UWRobotRacing/RR-Hummingbot-Hardware/Notes/Calibrations.xlsx

THROTTLE |  |  |  | STEERING
Input | Ideal | Measured | Delta | Input | Ideal | Measured | Delta | max | min |  | ROC
cm/s | us | us | us | degree | us | us | us | 200 | 10 | cm/s | 1.157894737
100 | 1684 | 1702 | 18 | 0 | 1500 | 1503 | 3 | 1800 | 1580
150 | 1742 | 1802 | 60 | 15 | 1616 | 1653 | 37
190 | 1788 | 1802 | 14 | 45 | 1850 | 1853 | 3 | -90 | 90 | deg | 7.777777778
 |  |  | 0 |  |  |  | 0 | 800 | 2200
 |  |  | 0 |  |  |  | 0
 |  |  | 0 |  |  |  | 0
 |  |  | 0 |  |  |  | 0
 |  |  |  |  |  |  | 0 | Resolution: | 50us | 5 deg
 |  |  |  |  |  |  | 0
