UWRobotRacing/RR-Hummingbot-Hardware/Electrical/PCB/hummingboard/v1/RR2019_Main_Board_V1/SENSOR_ACTUATOR.pdf

## 3 J11

## 3 J12

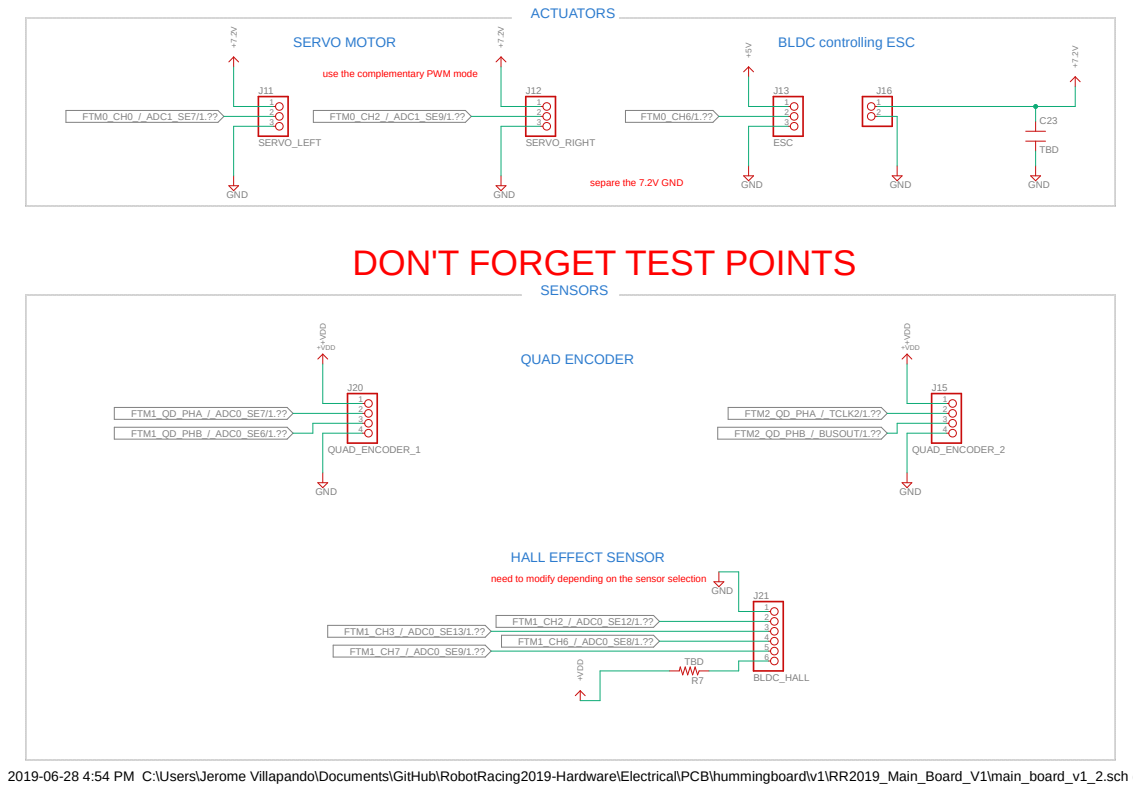
[picture p1: page 1]
SERVO_LEFT; SERVO_RIGHT; ESC; QUAD_ENCODER_2; GND; +VDD QUAD_ENCODER_1; +VDD; BLDC_HALL; TBD; 4 J15 ⁺VDD; +7.2V +VDD; FTM2_QD_PHA_/_TCLK2/1.??; FTM0_CH0_/_ADC1_SE7/1.??; FTM0_CH2_/_ADC1_SE9/1.??; FTM0_CH6/1.??; FTM1_CH2_/_ADC0_SE12/1.??; FTM1_CH3_/_ADC0_SE13/1.??; FTM1_QD_PHA_/_ADC0_SE7/1.??; FTM1_QD_PHB_/_ADC0_SE6/1.??; FTM1_CH6_/_ADC0_SE8/1.??; FTM1_CH7_/_ADC0_SE9/1.??; FTM2_QD_PHB_/_BUSOUT/1.??; ACTUATORS; SERVO MOTOR; BLDC controlling ESC; SENSORS; QUAD ENCODER

use the complementary PWM mode

separe the 7.2V GND

DON'T FORGET TEST POINTS
4 J20 ⁺VDD

HALL EFFECT SENSOR

need to modify depending on the sensor selection

2019-06-28 4:54 PM C:\Users\Jerome Villapando\Documents\GitHub\RobotRacing2019-Hardware\Electrical\PCB\hummingboard\v1\RR2019_Main_Board_V1\main_board_v1_2.sch (Sheet: 7/8)
