UWRobotRacing/RR-Hummingbot-Hardware/Electrical/PCB/hummingboard/v1/RR2019_Main_Board_V1/main_board_v1_2.pdf

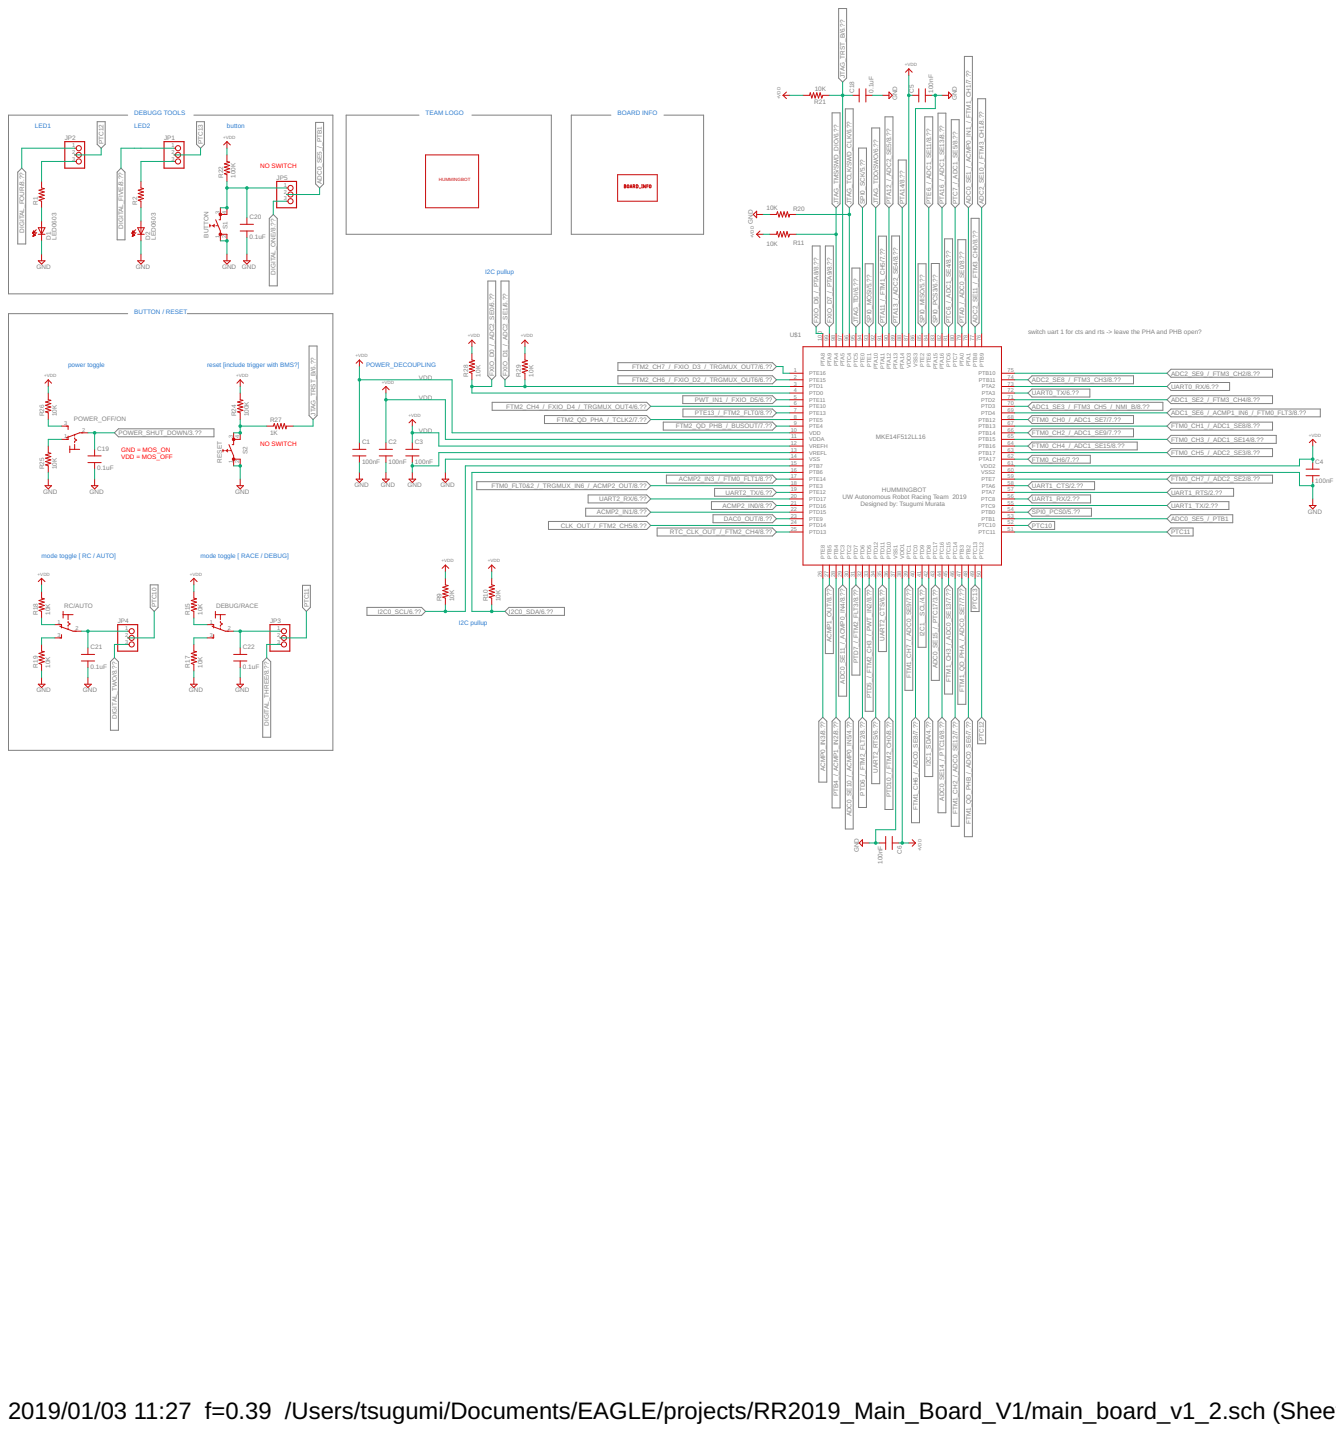
[picture p2: page 1]

switch uart 1 for cts and rts -> leave the PHA and PHB open?

HUMMINGBOT UW Autonomous Robot Racing Team 2019 Designed by: Tsugumi Murata

mode toggle [ RC / AUTO]
+VDD10K

mode toggle [ RACE / DEBUG]
+VDD10K 10K

2019/01/03 11:27 f=0.39 /Users/tsugumi/Documents/EAGLE/projects/RR2019_Main_Board_V1/main_board_v1_2.sch (Sheet: 1/8)
