UWRobotRacing/RR-Hummingbot-Hardware/Electrical/Simulation/component/LM2940/Draft1.asc

C2: cap; 22µ
LOAD: res; 10
U1: LM2940-N_5P0_TRANS
V1: voltage; 7.2
Named nets: 0, VIN, VOUT
.tran 200u
