UWRobotRacing/RR-Hummingbot-Hardware/Electrical/Simulation/5V - 3.3V logic level shifter/BSS138 level_shift.asc

R1: res; 10k
R2: res; 10k
U1: BSS138_ZTX
V1: voltage; 3.3
V2: voltage; 1.8
V3: voltage; PULSE(3.3 0 5u 300n 300n 0.6u 2.5u 5)
V4: voltage; PULSE(1.8 0 5u 300n 300n 0.6u 2.5u 5)
V5: voltage; 3.3
Named nets: 0, +5V, +1.8V, 5V_i2c, 3.3V_i2c, i2c_400khz_5V, i2c_400khz_1.8V, +3.3V
.MODEL MOD1 NMOS VTO=1 RS=1.58 RD=0.0 IS=1E-15 KP=0.395
    +CBD=53.5E-12 PB=1 LAMBDA=267E-6
    .MODEL Dmod1 D IS=1.254E-13 N=1.0207 RS=0.222
    .MODEL Dmod2 D CJO=40E-12
    .MODEL SMOD1a VSWITCH RON=1e-2 ROFF=1e4  VON=-1 VOFF=1
    .MODEL SMOD1b VSWITCH RON=1e-2 ROFF=1e4  VON=1 VOFF=-1
.tran 20u
BSS138
I2C timing characterization via fast mode
IMU (ICM-20948)
MCU (MKE14F512VLL16)
