UWRobotRacing/RR-Hummingbot-Hardware/Electrical/Simulation/5V - 3.3V logic level shifter/Draft1.asc

A1: or; td=4.2n Vhigh=5 Ref=2.5
R1: res; 10k
R2: res; 10k
U1: BSS138_ZTX
V1: voltage; 5
V2: voltage; PULSE(0 3.3 150u 1u 1u)
V3: voltage; PULSE(5 0 100u 1u 1u)
Named nets: 0, VDD, JETSON_GPIO, SWITCH, OUT
.tran 200u
