UWRobotRacing/RR-Hummingbot-Hardware/Electrical/Simulation/BoostConverterSimulation/11to12BoostSimulation.asc

C1: cap; 2.2µ
C2: cap; 160pf
C3: cap; 4.7µ
C4: cap; 0.1µ
D1: schottky; CRS08
L1: ind; 10µ
R1: res; 51k
R2: res; 13.3k
R3: res; 124k
R4: res; 12.9
U1: LMR64010_TRANS
V1: voltage; 11.1
Named nets: 0
.tran 100u
.MODEL CRS08 D (
+ IS = 1.3827e-005
+ N = 1.0382
+ RS = 0.24519
+ BV = 30
+ IBV = 1E-10
+ CJO = 4.7995e-10
+ M = 0.48186
+ VJ = 0.32607
+ TT = 0
+ TNOM = 25
+ XTI = -14.9618 )
