UWRobotRacing/RR-Hummingbot-Hardware/(list of files, drawings)

Other design files:
Electrical/Simulation/component/CRS08_Diode/CRS08.OLB
