UWRobotRacing/RR-Hummingbot-Hardware/Electrical/PCB/hummingboard/v1/RR2019_Main_Board_V1/main_board_v1_2.brd

## EAGLE design Electrical/PCB/hummingboard/v1/RR2019_Main_Board_V1/main_board_v1_2.brd (continued)

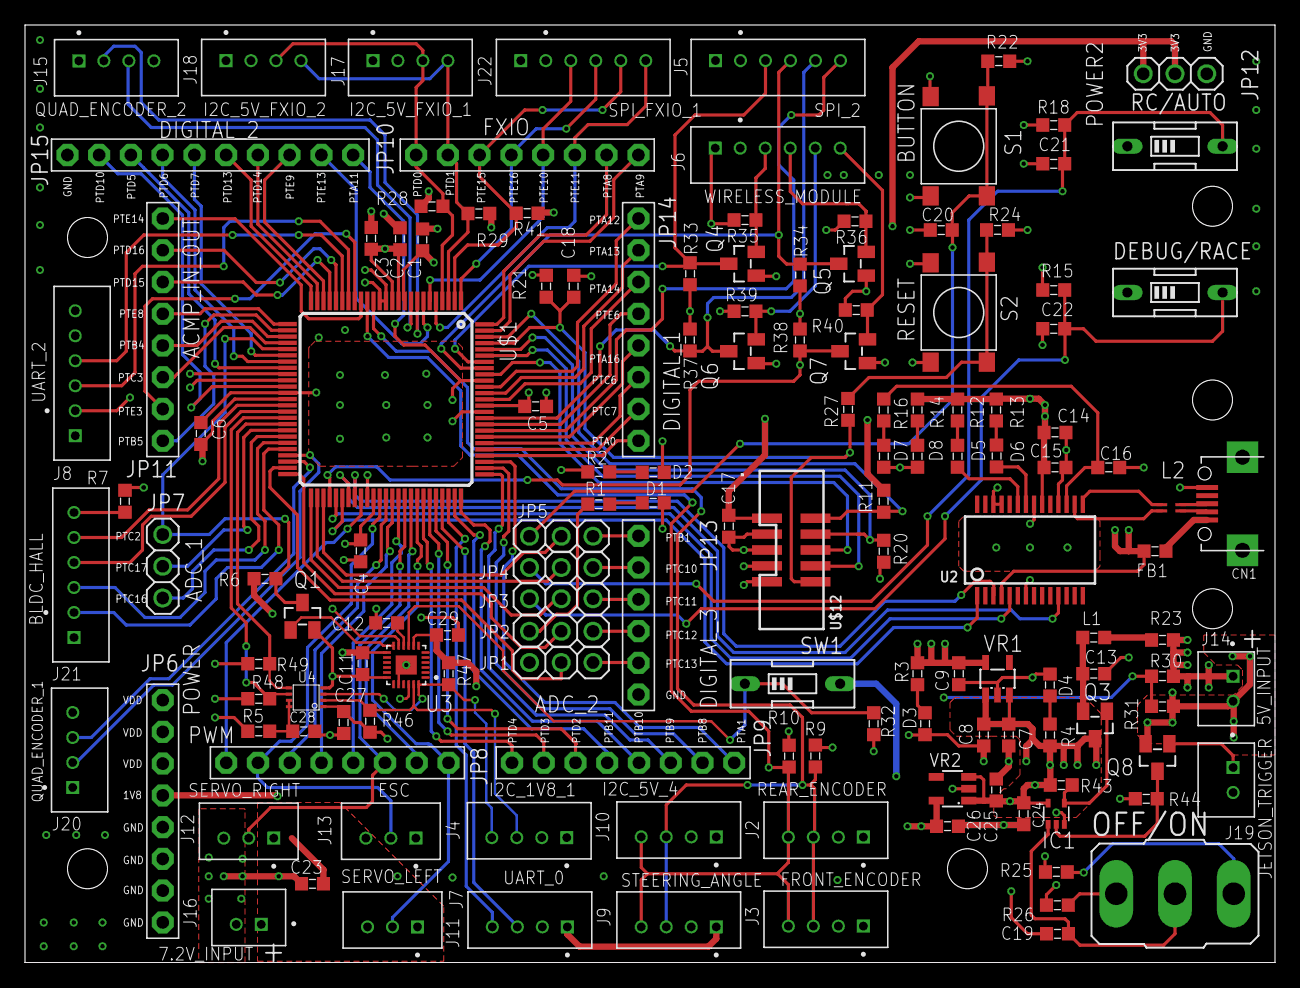
[picture p11: board main_board_v1_2.brd from above]

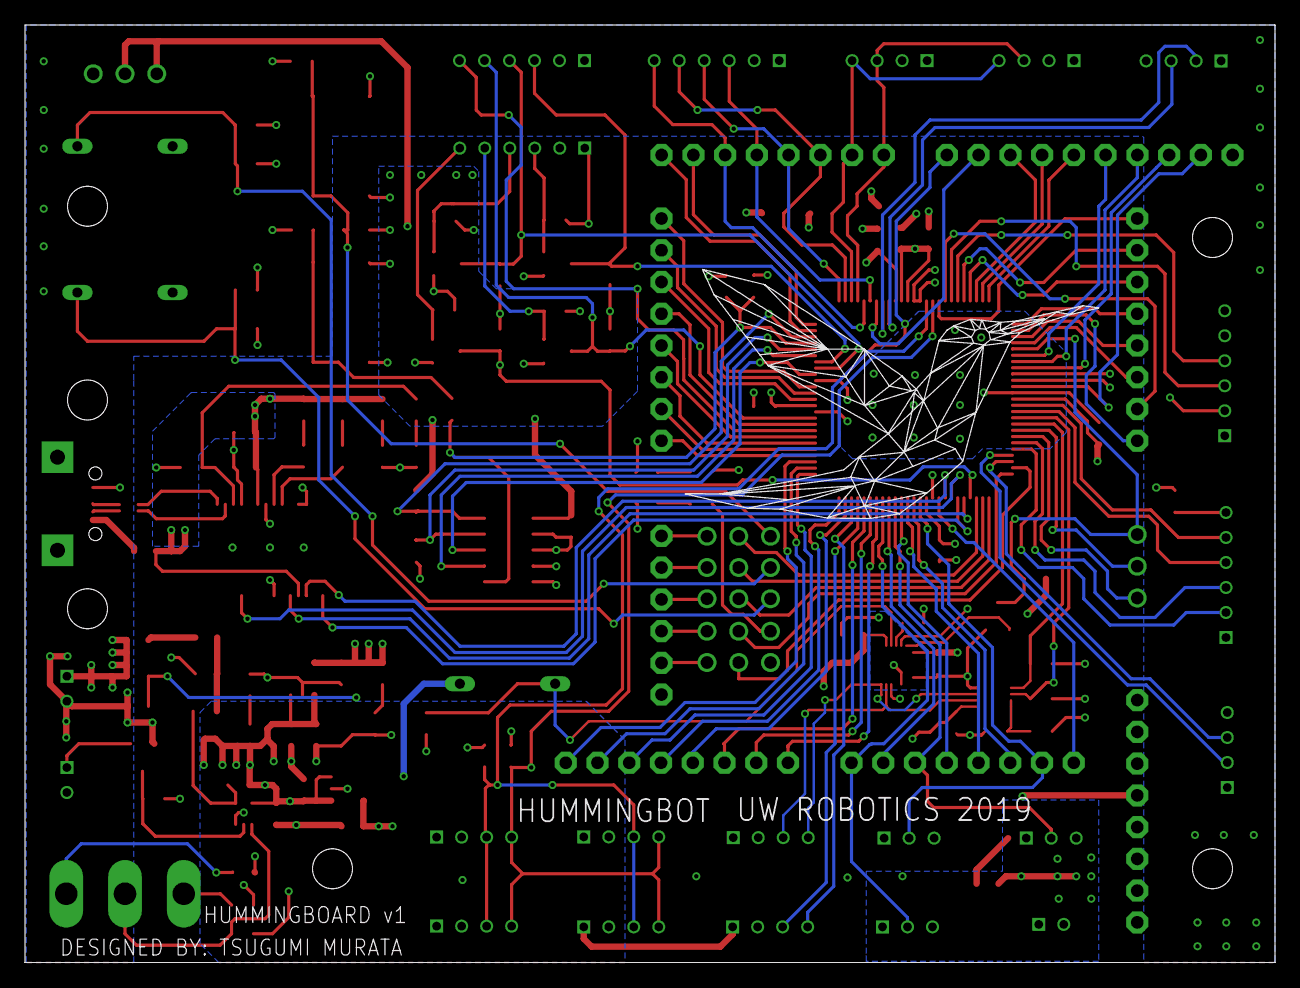
[picture p12: board main_board_v1_2.brd from below]

Board: 4 copper layers, 100.0 x 75.0 mm, 143 parts (2 on the bottom side), 142 nets.
