UWRobotRacing/RR-Hummingbot-Hardware/Firmware/hummingbot_firmware/Hummingbot_firmware/board/board.h

/*
 * Copyright 2016-2018 NXP Semiconductor, Inc.
 * All rights reserved.
 *
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
 * o Neither the name of NXP Semiconductor, Inc. nor the names of its
 *   contributors may be used to endorse or promote products derived from this
 *   software without specific prior written permission.
 *
 * THIS SOFTWARE IS PROVIDED BY THE COPYRIGHT HOLDERS AND CONTRIBUTORS "AS IS" AND
 * ANY EXPRESS OR IMPLIED WARRANTIES, INCLUDING, BUT NOT LIMITED TO, THE IMPLIED
 * WARRANTIES OF MERCHANTABILITY AND FITNESS FOR A PARTICULAR PURPOSE ARE
 * DISCLAIMED. IN NO EVENT SHALL THE COPYRIGHT HOLDER OR CONTRIBUTORS BE LIABLE FOR
 * ANY DIRECT, INDIRECT, INCIDENTAL, SPECIAL, EXEMPLARY, OR CONSEQUENTIAL DAMAGES
 * (INCLUDING, BUT NOT LIMITED TO, PROCUREMENT OF SUBSTITUTE GOODS OR SERVICES;
 * LOSS OF USE, DATA, OR PROFITS; OR BUSINESS INTERRUPTION) HOWEVER CAUSED AND ON
 * ANY THEORY OF LIABILITY, WHETHER IN CONTRACT, STRICT LIABILITY, OR TORT
 * (INCLUDING NEGLIGENCE OR OTHERWISE) ARISING IN ANY WAY OUT OF THE USE OF THIS
 * SOFTWARE, EVEN IF ADVISED OF THE POSSIBILITY OF SUCH DAMAGE.
 */

/**
 * @file    board.h
 * @brief   Board initialization header file.
 */
 
/* This is a template for board specific configuration created by MCUXpresso IDE Project Wizard.*/

#ifndef _BOARD_H_
#define _BOARD_H_

/**
 * @brief	The board name 
 */
#define BOARD_NAME "hummingboard_v1"

/*! @brief The UART to use for debug messages. */
#define BOARD_DEBUG_UART_TYPE 		kSerialPort_Uart
#define BOARD_DEBUG_UART_BASEADDR 	(uint32_t) LPUART1
#define BOARD_DEBUG_UART_INSTANCE 	1U
#define BOARD_DEBUG_UART_CLKSRC 	kCLOCK_ScgSysPllAsyncDiv2Clk
#define BOARD_DEBUG_UART_CLK_FREQ 	CLOCK_GetIpFreq(kCLOCK_Lpuart1)

#ifndef BOARD_DEBUG_UART_BAUDRATE
#define BOARD_DEBUG_UART_BAUDRATE 115200U
#endif /* BOARD_DEBUG_UART_BAUDRATE */

#if defined(__cplusplus)
extern "C" {
#endif /* __cplusplus */

/**
 * @brief 	Initialize board specific settings.
 */
void BOARD_InitDebugConsole(void);

#if defined(__cplusplus)
}
#endif /* __cplusplus */

#endif /* _BOARD_H_ */
