UWRobotRacing/RR-Hummingbot-Hardware/(commit log)

2019-01-10 add initial PCB files
    [main_board_v1.brd, main_board_v1.sch, main_board_v1_2.brd, main_board_v1_2.sch]
2019-01-10 initial commit for power managment board
    [power_managment_board_v1.brd, power_managment_board_v1.sch]
2019-01-12 Creating symbols for new power management ICs
2019-01-12 Created part for the 6V monitor and imported Boost part
2019-01-14 update on layout
    [main_board_v1_2.brd, main_board_v1_2.sch]
2019-01-17 Added Spice models and simulation for boost converter
    [CRS08.OLB]
2019-01-17 simulation file added
    [CRS08.OLB, main_board_v1_2.brd]
2019-01-17 updated trace
2019-01-17 add LM2940 component lib
    [CRS08.OLB]
2019-01-18 Created device LMR64010 to library
2019-01-18 Started schematic for boost converter
    [power_managment_board_v1.sch]
2019-01-18 Imported a diode library
    [power_managment_board_v1.brd, power_managment_board_v1.sch]
2019-01-22 add 5-3.3V logic level shift simulation
2019-01-23 Updated the SVS for 11.1V
    [power_managment_board_v1.brd, power_managment_board_v1.sch]
2019-01-23 power supply fixed
2019-01-23 [Journey Begins From Here] + new simulations and PCBs
    [main_board_v1_2.brd, main_board_v1_2.sch]
2019-01-24 Adding MCU pin config for initial pin assignments
2019-01-24 add OR logic for power control
2019-01-25 add 1.8V LDO and IMU change to ICM-20948
    [main_board_v1_2.brd, main_board_v1_2.sch]
2019-01-25 add ICM-20948 and 1.8V LDO
2019-01-26 signal connection complete
    [main_board_v1_2.brd, main_board_v1_2.sch]
2019-01-26 add 1V8, 3V3, VUSB power plane
    [main_board_v1_2.brd, main_board_v1_2.sch]
2019-01-27 add silkscreen for pin info
    [main_board_v1_2.brd, main_board_v1_2.sch]
2019-01-27 add silkscreen on SOT23
2019-01-27 silkscreen complete for board
    [main_board_v1_2.brd, main_board_v1_2.sch]
2019-01-28 change 2 switch to DIP and toggle smaller
    [main_board_v1_2.brd, main_board_v1_2.sch]
2019-01-28 add toggle switch
2019-01-30 layout complete v.1
    [main_board_v1_2.brd, main_board_v1_2.sch]
2019-01-30 layout and power planed modified, complete v2
    [main_board_v1_2.brd, main_board_v1_2.sch]
2019-01-31 gerber file
2019-01-31 increase 7.2V power plane size
    [main_board_v1_2.brd, main_board_v1_2.sch]
2019-02-11 gerber generated for modified board
    [.GBL, .GBO, .GBS, .GKO, .GTL, .GTO, .GTP, .GTS]
2019-02-11 remove inductor from 7.2V input / modify GND plane
    [main_board_v1_2.brd, main_board_v1_2.sch]
2019-02-11 gerber of modified board
    [bottomlayer.GBL, gerber_job.gbrjob, toplayer.GTL]
2019-02-11 add extra GND plane and via
    [main_board_v1_2.brd]
2019-02-22 add filter values
    [main_board_v1_2.brd, main_board_v1_2.sch]
2019-02-28 hummingboard_uart/led code
2019-03-01 PRINTF working, added button test code
2019-03-13 simple i2c and spi test code
2019-03-20 fix the MOSI/MISO direction
    [main_board_v1_2.brd, main_board_v1_2.sch]
2019-03-20 spi working
2019-03-22 modify ncs to clk timing issue for LPSPI
    [Hummingbot_firmware_FreeRTOS_2.c, board.h]
2019-04-19 [Added Core Testing Codes on Slave Devices] + BLDC Motor buit-in Encoder interface + ESC Motor FM/FB control interface + Remote Controller recv/send interface
2019-04-26 Pushing steering code
2019-04-29 [Arduino Lib] + nrf24l01 lib shared
2019-05-04 + removed unused & incompatible libraries
    [Hummingbot_firmware_FreeRTOS_2.c]
2019-05-17 [Finished RF24 Module] + TODO: SPI comm. not working
    [Hummingbot_firmware_FreeRTOS_2.c, RF24.c, RF24.h, common.h]
2019-05-18 [add printf func]
2019-05-23 [Fixed UART]
2019-05-23 + cannot get spi working
2019-05-31 [testing code] + working spi testing code
2019-06-09 [First Beta Version of RF24] + signals are quite similar to what to be expected + waiting to be tested once receiving new wireless modules
2019-06-11 [Working FTM testing code for PWM] + resolution of 10us + need to make the code to an usable lib
2019-06-11 [Servo Library] + servo library is working with a single servo, need further testing
2019-06-12 [Newborn: Vehicle Controller] + mainly to utilize servos to control vehicle + a place to put high level control algo.
2019-06-15 [A COMPLETE implementation of remote controller & esc] + finished/preserved all pipelines [TODOs] + need to add coordination + TBT + need to find proper gpios to use + need to doc. & Comment
2019-06-15 + tested & modified some code, Vehicle Controller is now in operation + 100% guarantee within 100us accuracy
    [Calibrations.xlsx, main_board_v1_2.brd]
2019-06-16 [fully tested code] + rf24 working along with vehicle controller
    [Calibrations.xlsx]
2019-06-16 testing configuration for servo
2019-06-22 Test RC with SERVO and THROTTLE
2019-06-25 + new clk config for servo, enabling 20us resolution without blocking + new feature: TBI, unfinished implementation of joystick mapping into VC controller + configurations defined
2019-07-03 Revert "jerome helo"
    This reverts commit 6a89c1981ca6536f5d6b027214bad50dcafaf769.
    [vehicleController.c]
2019-07-04 [Modified for ground test] + fixed freewheeling pulses
    [Hummingbot_firmware_FreeRTOS_2.c, vehicleController.c, vehicleController.h]
2019-07-04 Test code with fixed controller
    [Hummingconfig.h, vehicleController.c]
2019-07-09 Changed the esc frequency back to 50 Hz
2019-07-09 UART struct added, changed max ESC PWM and deadband
2019-07-13 i+ calibration mode
2019-07-13 + implemented reversing double-tick mechanism & fwd&rev braking
    [main.ino, vehicleController.c, vehicleController.h]
2019-07-13 i+ calibration
2019-07-13 calibrated steering and throttle
2019-07-13 + estop successfully, + uart echo
2019-07-14 + config gpio40 as debug led
2019-07-14 + non blocking deserialization + ._. why, arduino, why you do this to me??????????? 1s blocking for readString?????????
2019-07-14 + enabled debug mode with echo + fixed lost controller t 500ms, and fix its behaviour
    [main.ino]
2019-07-14 + only turn on uart when auto mode
2019-07-14 + interrupt block read
2019-07-14 + unit test for uart
2019-07-14 + working uart version
2019-11-14 + m4 uart communication
